SebSal/departure-board-zephyr/(commit log)

2026-10-27 First beta version
    [back.scad, back_nohole.scad, front.scad]
2026-10-29 Make power options optional.
2026-10-29 Add constantly powered eink variant.
2026-10-29 Add non sleep cycle.
    Available for non battery powered devices only.
2026-10-29 Make refresh cycle configurable.
    Enable the configuration of the refresh cycle time on
    permanently powered devices.
2026-10-29 Fix parser to ignore trams that already left.
    Now only depaturtes that are after the current time are shown.
